Sadrak2017/antena_yagi-uda/YagiUDA_2_45Ghz_Final/Temp/Print.bmp

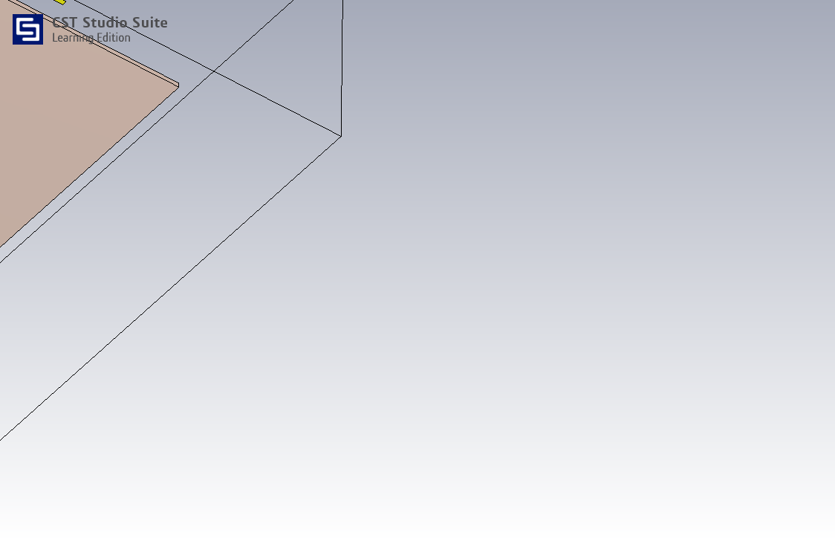
YagiUDA_2_45Ghz_Final/Temp/Print.bmp
