Sadrak2017/antena_yagi-uda/YagiUDA_2_45Ghz_Final/Model/Reports/a20d24b001a24a13bbddfeab5e1fd9bf/8b24a912df724c59a998ee79b5da223a.png

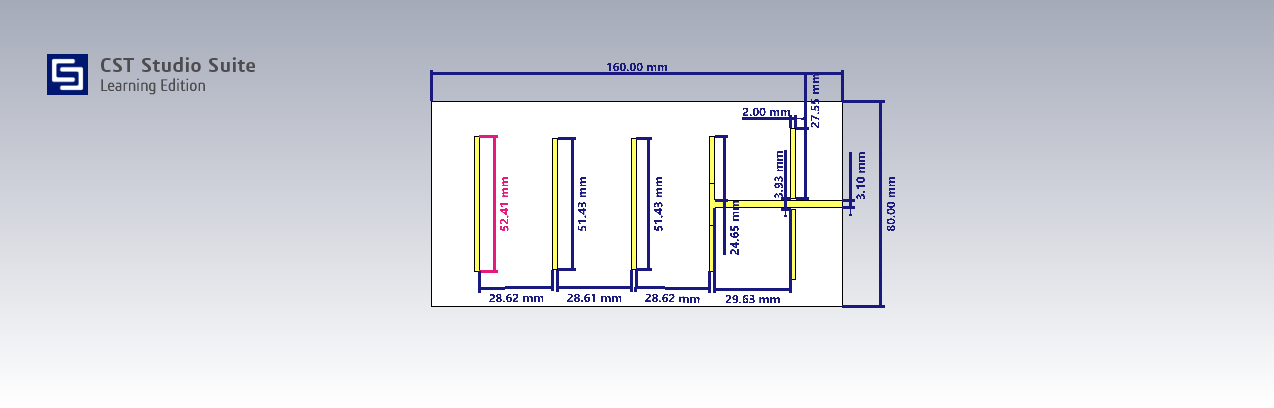
YagiUDA_2_45Ghz_Final/Model/Reports/a20d24b001a24a13bbddfeab5e1fd9bf/8b24a912df724c59a998ee79b5da223a.png
