Sadrak2017/antena_yagi-uda/README.md

# antena_yagi-uda
Antena Yagi UDA alimentada por microfita na frequência de 2,45Ghz e 50 Ω de impedância de entrada
