Sadrak2017/antena_yagi-uda/Relatório.pdf

Sadrak_earth@outlook.com

## Universidade Tecnológica Federal do Paraná Departamento de Engenharia Eletrônica - DAELN Eletromagnetismo 2: Linhas e Antenas

Sadrak da Silva
Graduando Eng. Eletrônica

## Antena Yagi UDA alimentada por microfita na frequência de 2,45Ghz e 50 Ω de impedância de entrada

Curitiba/PR
2023

Sumário

### 1. INTRODUÇÃO

As antenas desempenham um papel crucial na comunicação sem fio, sendo essencial que possuam dimensões compactas e desempenho eficiente. Um tipo de antena adequado para atender às necessidades desta tecnologia é a antena de microfita. Além, de apresentar diversas vantagens em comparação com outros tipos de antenas, nomeadamente formatos pequenos e finos, peso leve, fácil de fabricar, custo relativamente baixo e facilidade de integração. Em geral, uma das desvantagens das antenas de microfita é que elas têm um

baixo ganho, mas essas deficiências podem ser reduzidas ajustando o formato. Uma técnica que possui um alto valor de ganho é fornecer um refletor e um diretor, como em um arranjo de antenas Yagi-Uda em geral. As antenas de Yagi-Uda são bem conhecidas desde sua proposta por UDA em

1927 e a publicação por Yagi em 1928. A configuração geralmente consiste em uma série de elementos dipolo lineares, um dos quais é acionado diretamente, enquanto a corrente restante é induzida por um acoplamento mútuo, consistindo em uma série de diretores e refletores que aumentam a radiação em uma direção quando devidamente apoiados em um estrutura suporttada.

### 2. METODOLOGIA

Esta categoria de antena pode ser otimizada para atender a diferentes requisitos, como ganho, impedância ou largura de banda. Para um design ideal, é crucial que o espaçamento e o comprimento do diretor não sejam uniformes. O projeto desenvolvido foi baseado no artigo "Microstrip-Fed Yagi-Uda Dipole

Array Antenna At 3.6 GHz Frequency For 5G Application", publicado no IEEE em 2019. Os autores utilizaram a metodologia da norma NBS 688, derivada de experimentos

detalhados por Peter P. Viezbicke para o NBS (National Bureau of Standards). Embora essa norma não tenha sido originalmente projetada para antenas de

microfita, ajustes pós-fase inicial são necessários. Após obter as dimensões conforme a NBS 688 e realizar tentativas e ajustes

no software CST Studio 2022, foi possível obter os valores ideais para convergir o parâmetro S11 para a frequência de operação desejada, 2,45 GHz, e a impedância de entrada de 50 ohms.

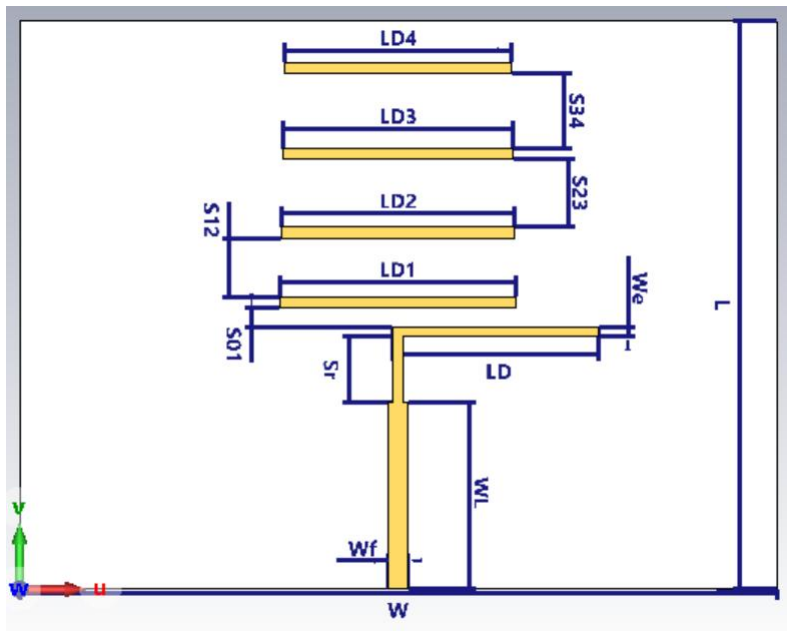
[picture p3: figure]

Figura 1: Esboço do arranjo dipolo Yagi-Uda alimentado por microfita vista superior

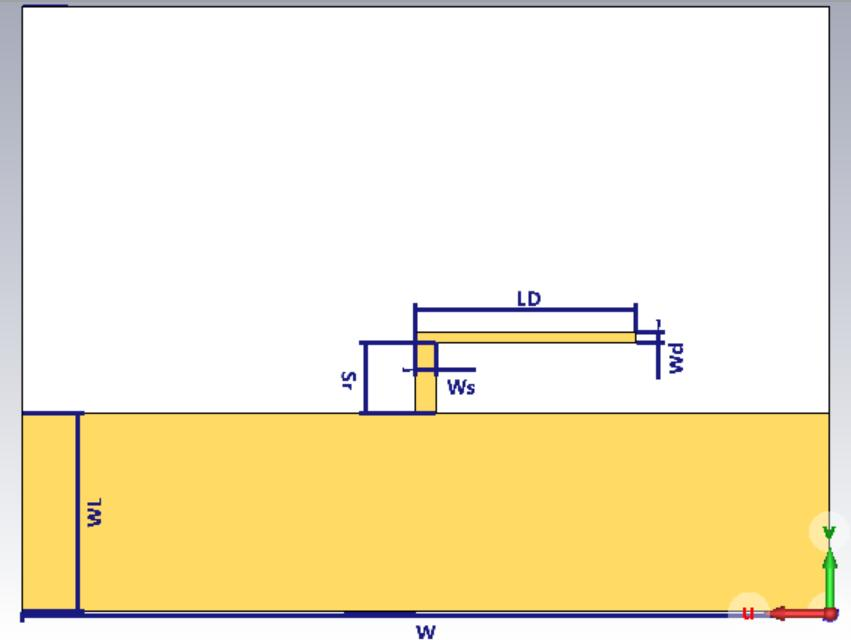
[picture p4: figure]

Figura 2: Esboço do arranjo dipolo Yagi-Uda alimentado por microfita vista inferior Nas figuras 1 e 2 têm-se as nomenclaturas das dimensões de cada elemento

da antena. Essas nomenclaturas serão usadas no desenvolvimento para projetar e simular a antena Yagi-UDA de microfita.

### 3. DESENVOLVIMENTO

Seguindo a norma NBS 688, o primeiro passo consiste em determinar os parâmetros fundamentais da antena, incluindo o ganho relativo, comprimento total, comprimento dos refletores, diretores e do dipolo, bem como os espaçamentos entre esses elementos. Essa análise é realizada com base na Tabela 1, que apresenta comprimentos e espaçamentos otimizados em relação ao comprimento de onda (λ), sendo a escolha guiada pelo ganho desejado.

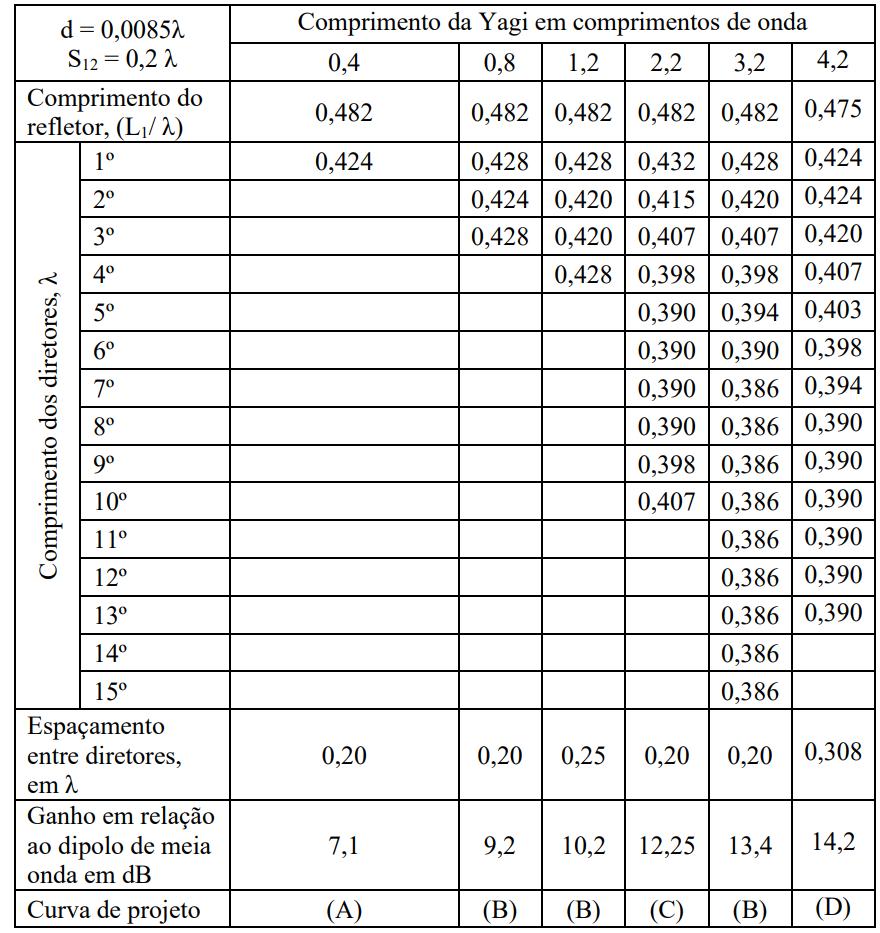
[picture p5: figure]

Tabela 1: Comprimentos otimizados de elementos parasitas para antenas yagi.

Equação 1

Uma vez que a frequência de operação é 2,45Ghz, e o substrato utilizado é a placa de fibra de vidro FR-4, abaixo na equação 1, têm-se o valor do comprimento de onda (λ), dado que a placa utilizada FR - 4 apresenta → = 4.4
λ =

∗ = 58,3753 mm

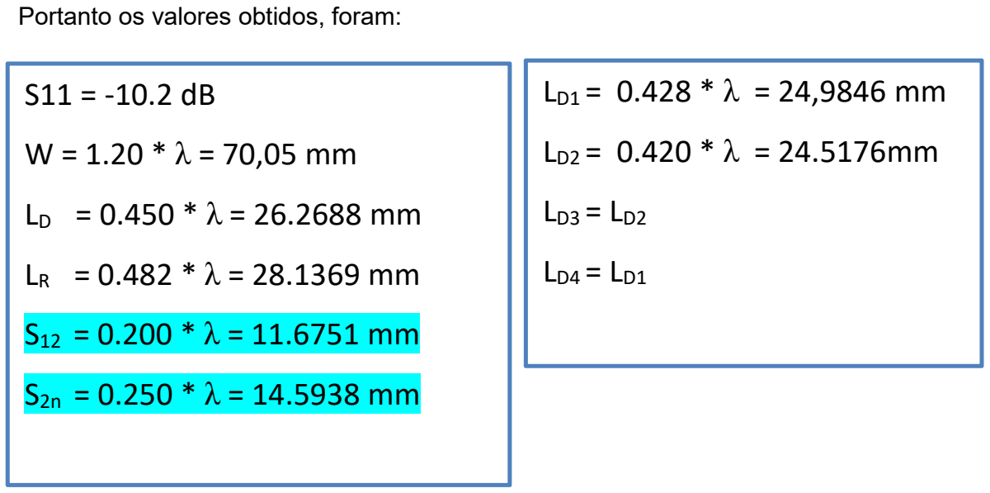
[picture p6: figure]
Portanto os valores obtidos, foram:

Ao simular a antena no CST Studio com estes valores, os resultados não foram satisfatórios, a figura 3 evidencia o gráfico em função do paramêtro S11.

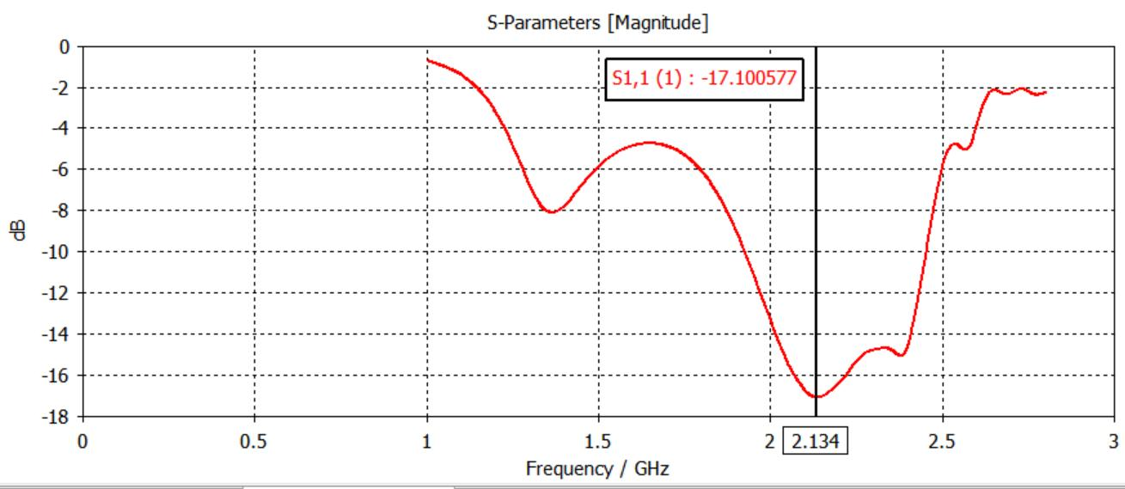
[picture p7: figure]

Figura 3: simulação da antena Yagi-Uda de microfita com os valores da norma NDB 688

Como o objetivo é projetar uma antena de Yagi-Uda que opera em 2,45Ghz com pelo menos -10db no parâmetro S11, usando a metodologia tentativa/erro os valores foram ajustados para obter esse resultado.

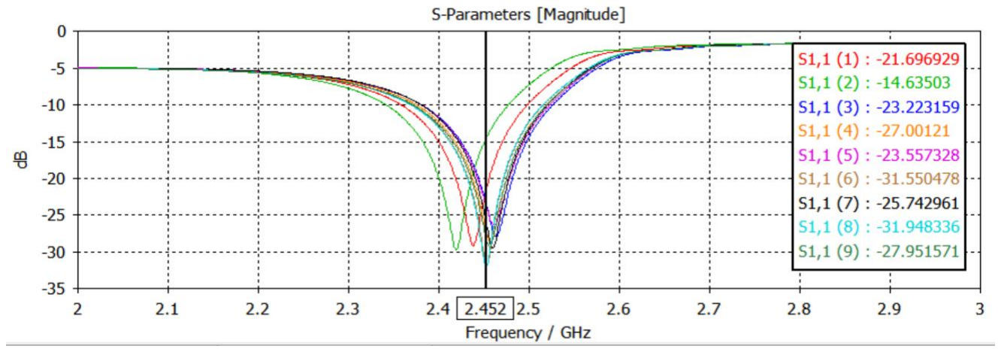
[picture p8: figure]

Figura 4: Resultados das simulações ajustando as dimensões para obter os valores ideais. Após várias simulações, os valores ideais para a antena Yagi-Uda de microfita

foram estes presente na tabela 1:
Parâmetro | Expressão | Valor | Descrição
LD | 0,54535 * λ | 31,8349 mm | Tamanho do dipolo/refletor
LD1 | 0,62450 * λ | 36,4553 mm | Tamanho do diretor 1
LD2 | 0,61746 * λ | 36,0443 mm | Tamanho do diretor 2
LD3 | 0,60929 * λ | 35,5674 mm | Tamanho do diretor 3
LD3 | 0,60171 * λ | 35,1249 mm | Tamanho do diretor 4
S01 | 0,05076 * λ | 2,9771 mm | Distancia entre dipolo e diretor 1
S12 | 0,15537 * λ | 9,9631 mm | Distancia entre diretor 1 e 2
S23 | 0,17781 * λ | 10,3797 mm | Distancia entre diretor 2 e 3
S34 | 0,19888 * λ | 11,6096 mm | Distancia entre diretor 3 e 4
Wd | 0,02920 * λ | 1,7045 mm | Espessura dos diretores
Ws | Wd² | 2,9055 mm | Largura sustenção dipolo face GND
We | 0,82500 * λ | 1,4062 mm | Largura dipolo
Sr | 0,17487 * λ | 10,2080 mm | Altura entre casador/gnd e dipolo
WL | 0,49232 * λ | 28,7393 mm | Altura GND
L | (3/2) * λ | 87,5628 mm | Comprimento da placa
tc | - | 0,04000 mm | Espessura do cobre
Wf | 0,05100 * λ | 2,9771 mm | Largura do casador de impedância
W | 2,00000 * λ | 116,7505 mm | Comprimento graund
h | - | 1,60000 mm | Espessura do substrato

Tabela 2: Valores ideais para antena Yagi-Uda de microfita para operar em 2,45Ghz A figura 5 evidência o excelente resultado para o parâmetro S11, com cerca de

-50db exatamente em 2,45Ghz.

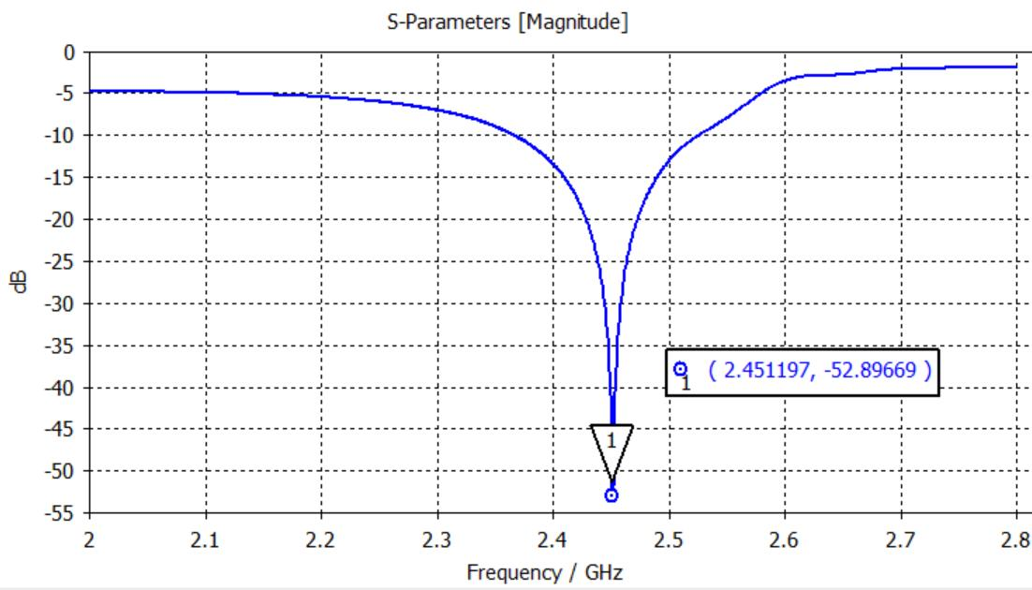
[picture p9: figure]

Figura 5: Resultado da simulação, frequência de operação em função do parâmetro S11 em decibéis A impedância de entrada foi ajustada com sucesso para exatos 50 ohms, conforme desejado. O parâmetro crucial para esse casamento de impedância é a

largura (Wf). Notavelmente, a largura é inversamente proporcional à impedância de entrada, indicando que um aumento na largura resulta em uma queda significativa na impedância. Durante a simulação, identificou-se que com uma largura de 5.4 mm, a impedância de entrada diminui para aproximadamente 30 ohms, enquanto o valor ideal para alcançar os 50 ohms desejados é de cerca de 2,9 mm.

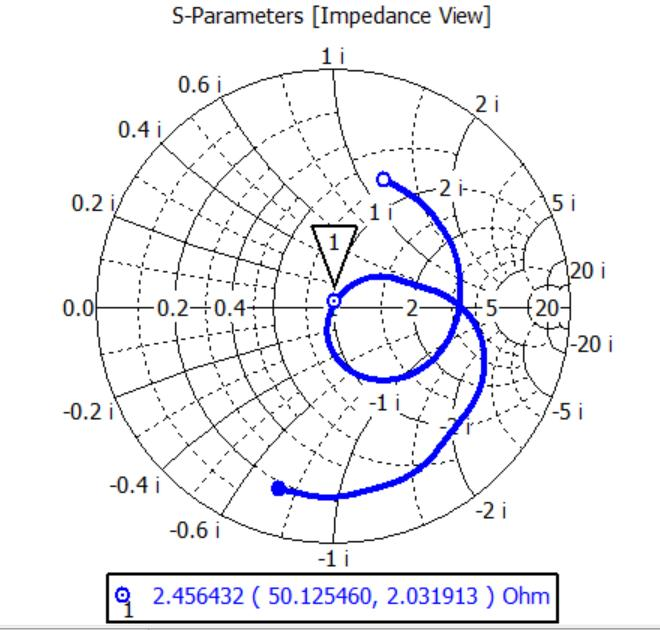
[picture p10: figure]

Figura 6: Impedância de entrada para 2,45Ghz

O "Voltage Standing Wave Ratio (VSWR)" é um parâmetro crucial em antenas e sistema de radio frequência, medindo o descasamento de impedância. Em situações ideais, quando a carga é perfeitamente compatível com a fonte, o VSWR será igual a
1. Isso implica em uma eficiente transferência de energia entre a fonte e a carga, indicando um casamento de impedância ideal.

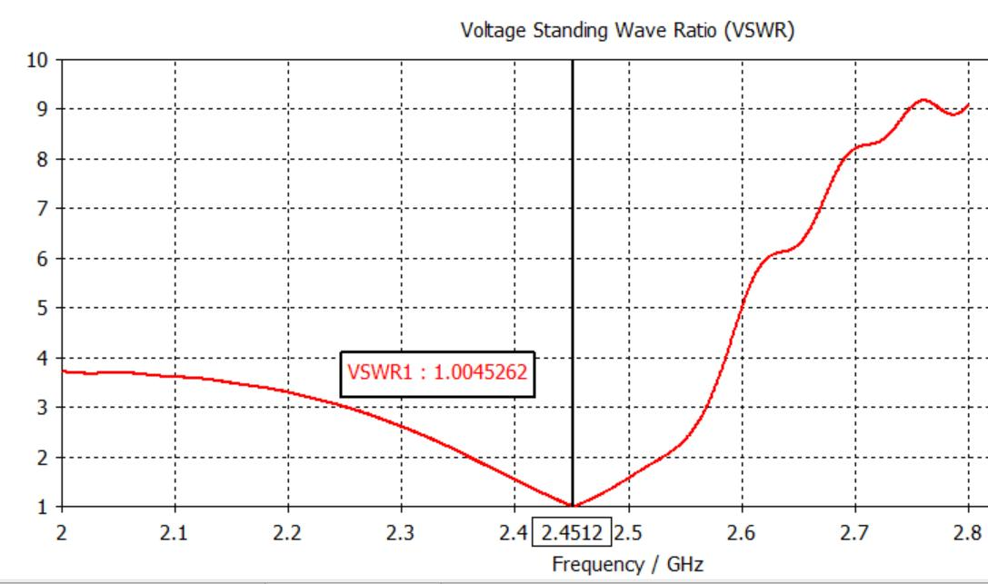
[picture p11: figure]

Figura 7: Grafico do valor de SWR, demonstrando o excelente valor para antena de 2,45Ghz projetada. O padrão de radiação e diretividade também ficaram satisfatórios, com um

ganho de 8,62 dBi, a antena projetada demonstrou-se relativamente eficiente.

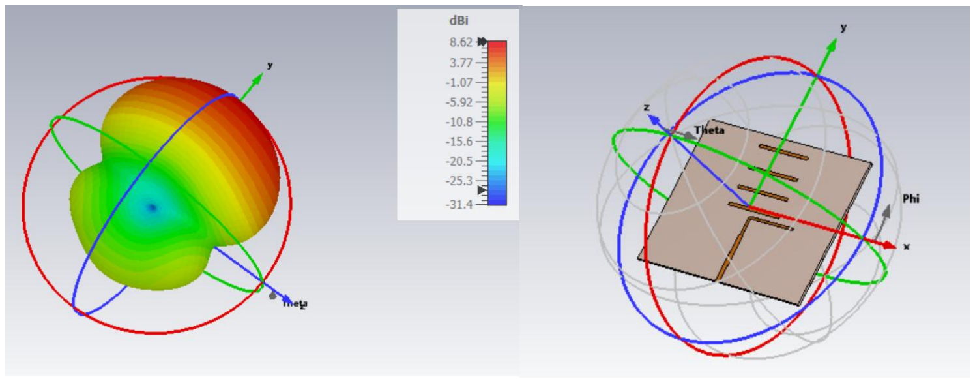
[picture p12: figure]

Figura 8: Padrão de radiação

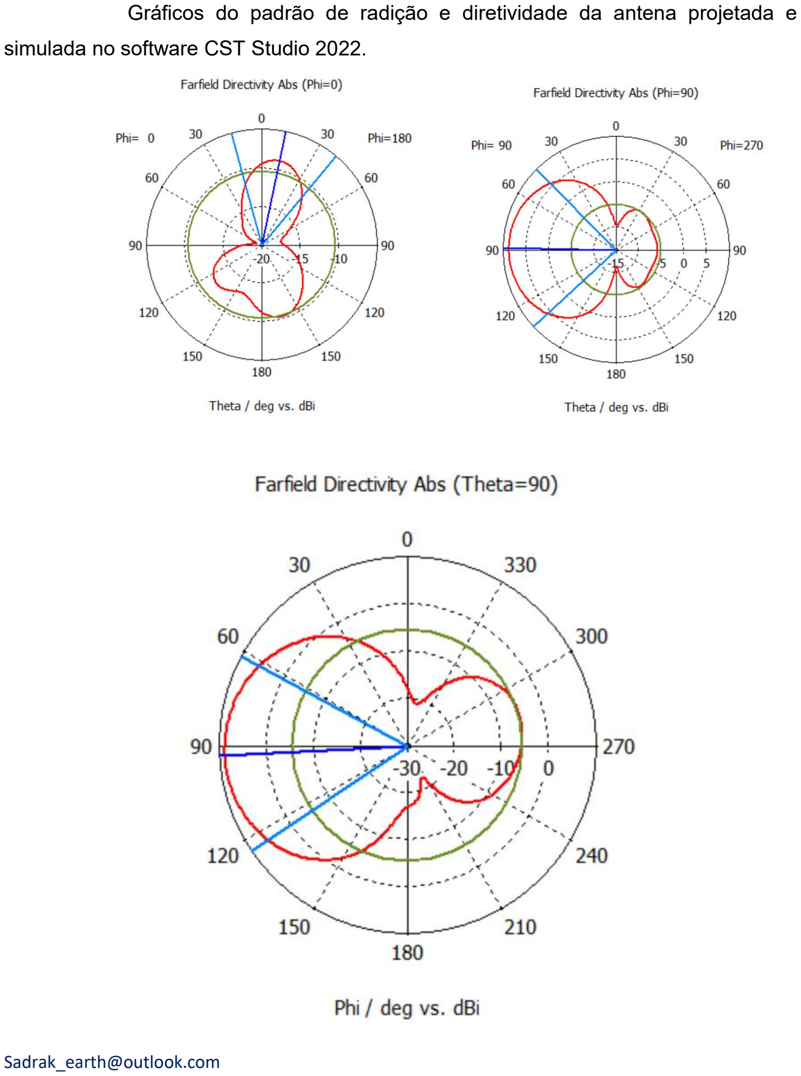
[picture p13: page 11]

Gráficos do padrão de radição e diretividade da antena projetada e simulada no software CST Studio 2022.

A figura abaixo demonstra com mais precisão os valores exatos utilizados na simulação, quase todos em função do comprimento de onda.

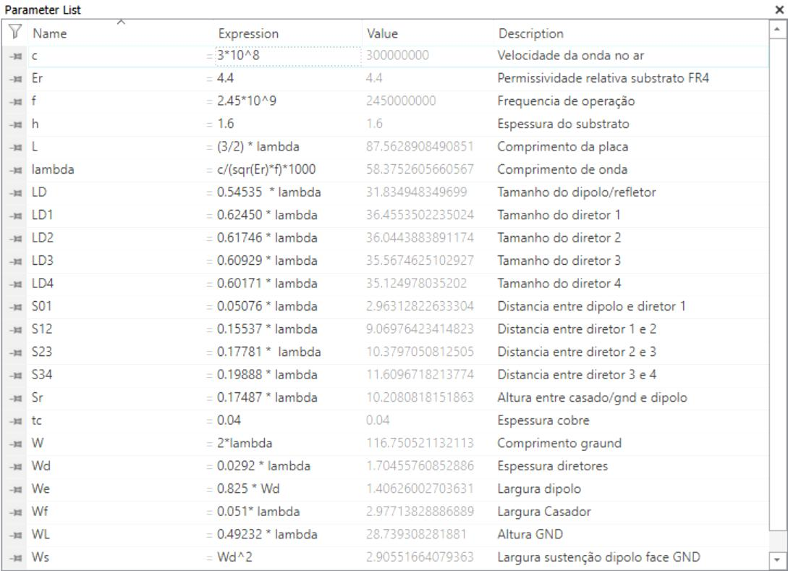
[picture p14: figure]

Figura 9: Print da lista de parâmetros utilizados no software CST Studio 2022

### 4. CONFECÇÃO DA PLACA DE CIRCUITO IMPRESSO

A confecção da placa foi realizada por meio do método fotográfico conhecido como 'Transferência Térmica'. Este método, amplamente utilizado por entusiastas de eletrônica, proporciona resultados excelentes tanto para placas de face simples quanto para face dupla.
Inicialmente, a antena foi impressa com suas dimensões reais em papel couchê 170g. Destaca-se a importância de manusear as folhas impressas com cuidado, evitando o toque no circuito para prevenir a transferência de gorduras, as quais

podem impactar negativamente na qualidade da transferência térmica para a placa.

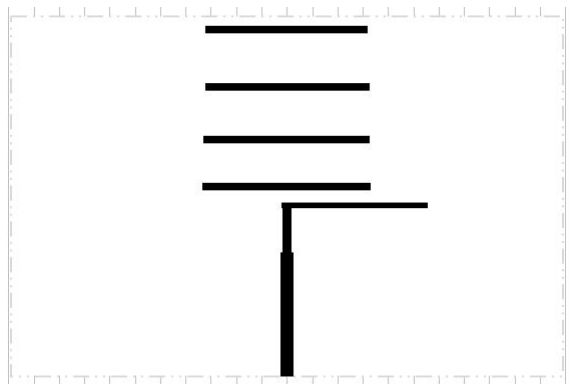
[picture p15: figure]
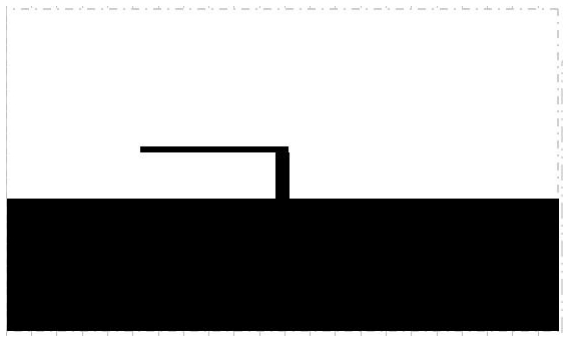
[picture p16: figure]

Figura 10: Desenho da placa preparado para impressão com papel couchê 170g
Em seguida, a placa foi cuidadosamente limpa com detergente e secada com um secador de cabelo. Em seguida, a folha com o circuito impresso foi posicionada sobre a placa, e utilizando um ferro de passar roupa, realizou-se movimentos circulares por cerca de 10 minutos. Posteriormente, a placa foi submersa em água fria para criar um choque

térmico. Com a tinta transferida para a placa, o próximo passo envolveu a imersão na solução corrosiva de percloreto para obter apenas o circuito desejado.

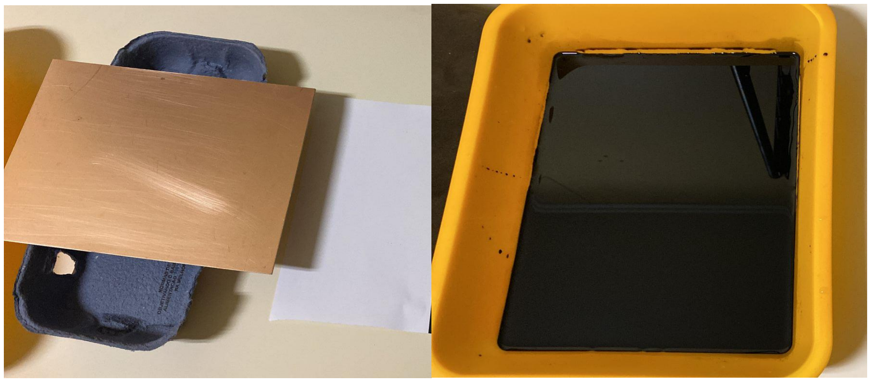
[picture p17: figure]

Figura 11: Placa de fibra de vidro FR-4 e ao lado o corrosivo percloreto.

O resultado final da antena é evidênciada pela figura 12.

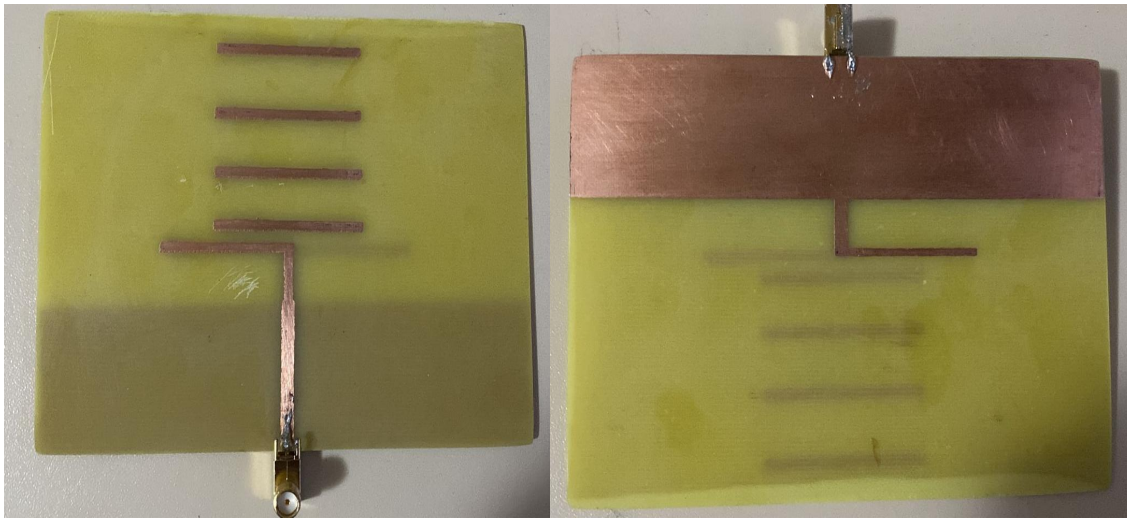
[picture p18: figure]

Figura 12: Antena Yagi-Uda de microfita com frequência de operação de 2,45Ghz

### 5. MEDIÇÕES

As medições dos parâmetros S11 e impedância de entrada são destacadas na Figura 13 e 14. Embora, nas simulações, a antena tenha operado precisamente em 2,45 GHz, as medições revelaram uma pequena diferença de aproximadamente 40 MHz, convergindo para 2,49 GHz. No entanto, essa discrepância pode ser atribuída às limitações/precisão do equipamento utilizado ou ainda à imprecisão na confecção da placa utilizando o método caseiro fotográfico, o qual é relativamente bom porém não é tão preciso. Importante notar que, apesar dessa variação, a antena projetada atendeu aos requisitos pretendidos.

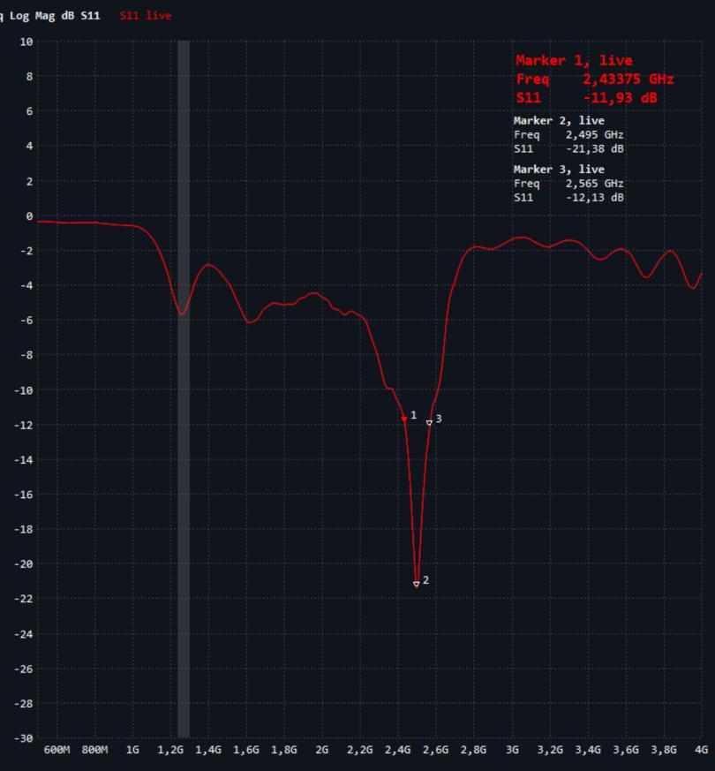
[picture p19: figure]

Figura 13: Resultados das medições da antena referente ao parâmetro S11.

A impedância de entrada ficou em cerca de 43 ohms, também relativamente próximo dos 50 ohms que era o objetivo. Outro fator que pode ter afetado os valores medidos é a espessura do casador de impedância que é muito sensível à alteração, uma vez que o método fotográfico de impressão da placa pode apresentar

imprecisões no valor da dimensão Wf.

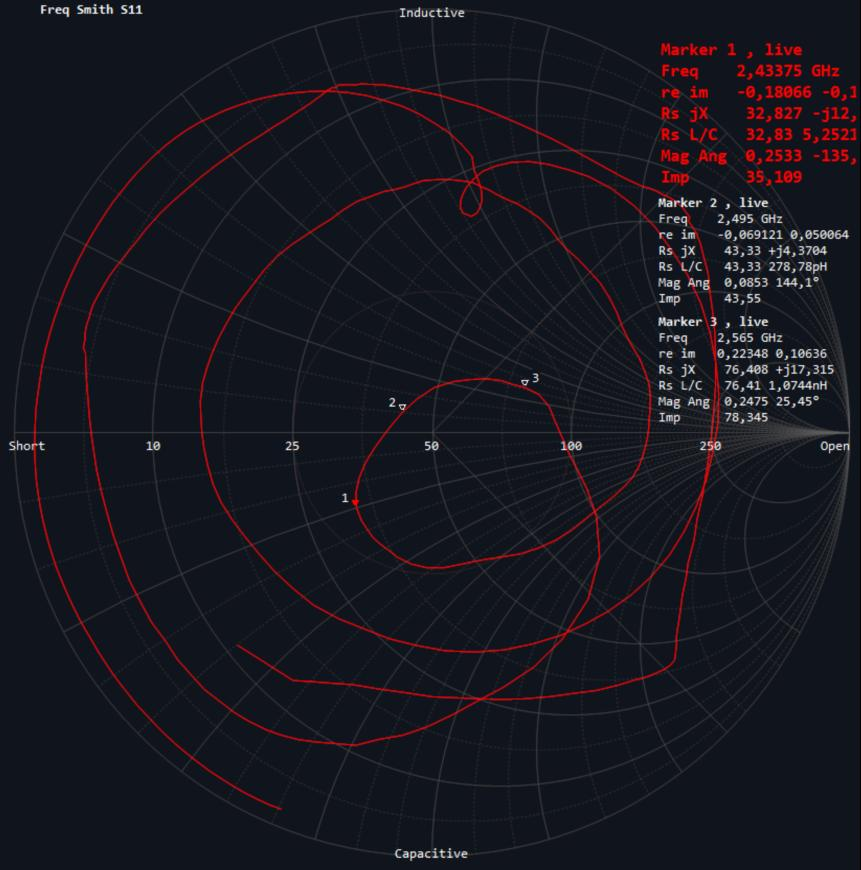
[picture p20: figure]

Figura 13: Resultados das medições da antena referente à impedância de entrada.

Equação 2

Equação 3

Equação 4

Equação 5

Equação 6

### 6. ANÁLISES E CURIOSIDADES

Dado que os parâmetros geométricos da antena são dependentes do comprimento de onda, foram conduzidos estudos para derivar equações que descrevessem a relação entre o design da Yagi-Uda implementada e a impedância de entrada em função do comprimento de onda, espessura do cobre, espessura da placa e do casador de impedância (Wf). A equação resultante, desenvolvida para descrever a impedância de entrada, é a seguinte:

Z0 =

# λ ∗ (1−1,15ℎ )s()

# , pp pl p plp 1, Z0 = 49.73 Ω

Fazendo a operação inversa para obter o valor de , tem-se:

# = sin

−1

∗ (1−1,15ℎ )Z0
, para os valores da tabela 1, = 2,90 mm

A equação que descreve as dimensões dos diretores:

# LDn =

1

ℎ +
∗

+
∗ℎ

200 ∗ , l = 0, 1, 2, . . . , 2∗

− 1

A equação que descreve a dimensão da espessura dos diretores:

# WD = Wf

# , pp = 2,90 mm → WD = 1.703 mm

A equação que descreve a dimensão da espessura da haste de sustenção do dipolo na face inferior, com base na tabela 1 e figura 2:

# Ws = WD 2 pp = 1.703 mm → Ws = 2.90 mm

São curiosidades e análises que podem resultar em um artigo ou tema de TCC.

### 7. DISCUSSÃO E CONCLUSÃO

A partir da proposta inicial, foi possível simular, projetar e medir os parâmetros da antena de microfita Yagi-Uda na frequência de 2,45 GHz, mantendo a impedância de entrada em 50 ohms. Durante o desenvolvimento, como a maioria dos valores estava relacionada ao

comprimento de onda, tentou-se derivar equações que descrevessem não apenas a antena para a frequência de 2,45 GHz, mas também para uma ampla faixa de frequências. Contudo, devido à não linearidade dos parâmetros em relação ao comprimento de onda, encontrar essas equações tornou-se desafiador. Apesar disso, esforços estão sendo mobilizados para identificar padrões que

possam se aplicar a diferentes frequências, reconhecendo a importância e o valor que isso traria para a comunidade de engenharia.

### 8. REFERÊNCIAS

- IEEE, Department of Electrical Engineering Gunadarma University, Depok, Indonesia. Microstrip-Fed Yagi-Uda Dipole Array Antenna At 3.6 Ghz Frequency For 5G

Application. Acesso em 10 dez 2023. - Balanis, Antenna Theory – Analysis and Design, 3ª ed, 10.3.3 Yagi-Uda Array of

Linear Elements. Acesso em 2 dez 2023. - Medidas de Caracterização Eletromagnética de Materiais em Espaço Livre na Banda

C. https://www.sige.ita.br/edicoes-anteriores/2019/st/ST_12_3.pdf. Acesso em 8 dez 2023.
