Sadrak2017/antena_yagi-uda/(list of files, cad)

Other CAD files:
YagiUDA_2_45Ghz_Final/ModelCache/Model.psm
YagiUDA_2_45Ghz_Final/Result/Port1_e1.prt
YagiUDA_2_45Ghz_Final/Result/Port1_e1[2.4].prt
YagiUDA_2_45Ghz_Final/Result/Port1_h1.prt
YagiUDA_2_45Ghz_Final/Result/Port1_h1[2.4].prt
YagiUDA_2_45Ghz_Final/Result/adapt_Port1_e1.prt
YagiUDA_2_45Ghz_Final/Result/adapt_Port1_e1[2.4].prt
YagiUDA_2_45Ghz_Final/Result/adapt_Port1_h1.prt
YagiUDA_2_45Ghz_Final/Result/adapt_Port1_h1[2.4].prt
