Sadrak2017/antena_yagi-uda/(list of files, drawings)

Other design files:
YagiUDA_2_45Ghz_Final/Model/3D/Model.dsn
YagiUDA_2_45Ghz_Final/Model/DS/Model.dsn
